willie68/OpenSeaMapLogger/Hardware/OSML_Beschreibung.jpg

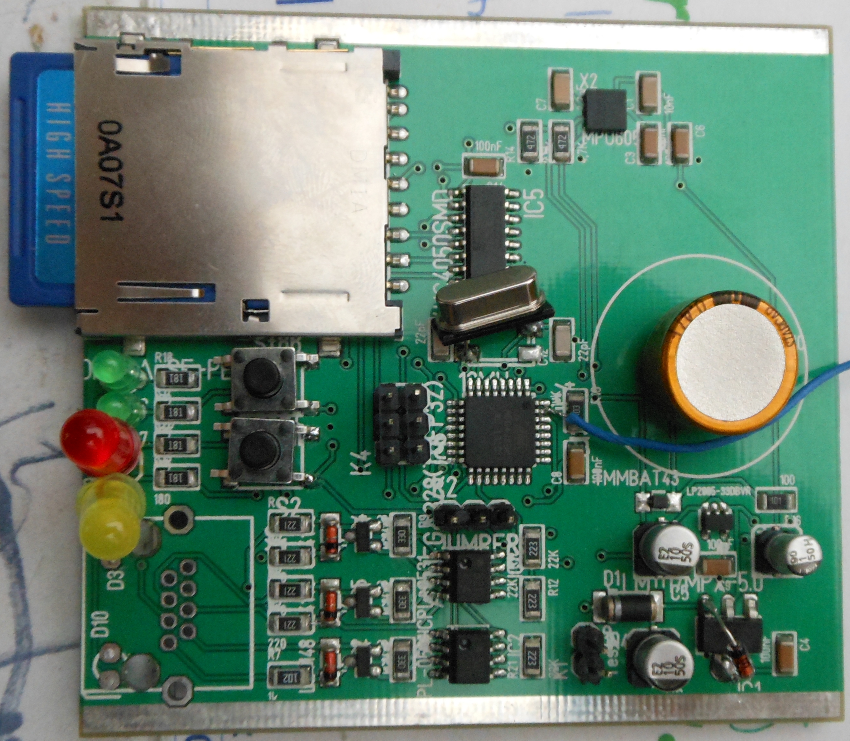
Hardware/OSML_Beschreibung.jpg
