willie68/OpenSeaMapLogger/documentation/DSC_1755.png

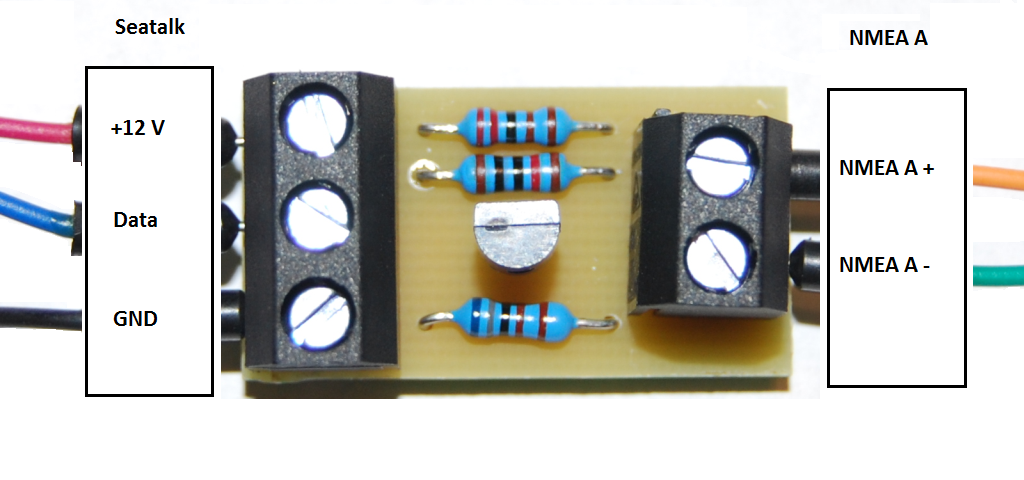
documentation/DSC_1755.png
