willie68/OpenSeaMapLogger/documentation/783px-OpenSeaMap-Logger-NMEA-0183-PS.jpg

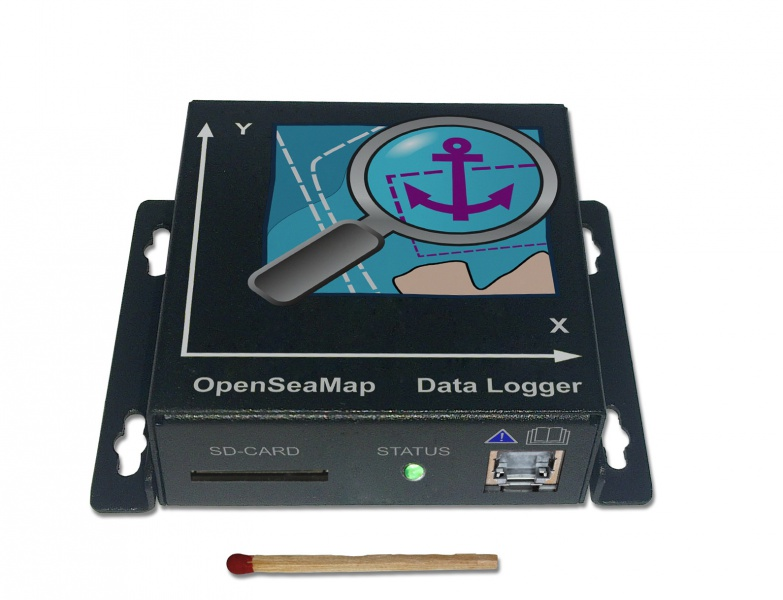
documentation/783px-OpenSeaMap-Logger-NMEA-0183-PS.jpg
