willie68/OpenSeaMapLogger/documentation/800px-Wire_blue_white_stripe.svg.png

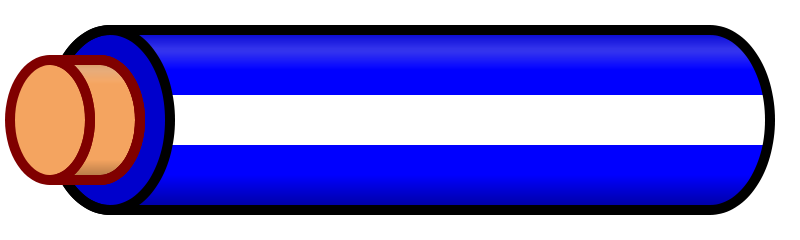
documentation/800px-Wire_blue_white_stripe.svg.png
