willie68/OpenSeaMapLogger/documentation/800px-Wire_white_green_stripe.svg.png

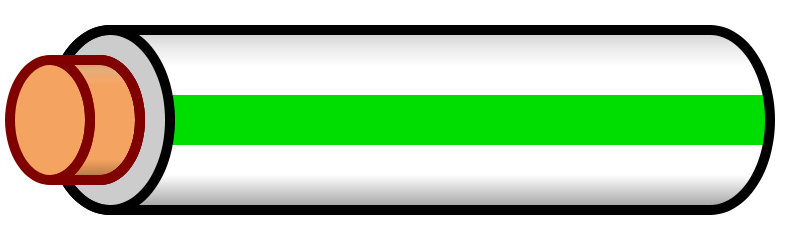
documentation/800px-Wire_white_green_stripe.svg.png
