willie68/OpenSeaMapLogger/documentation/Bilder/Seatalk_001.jpg

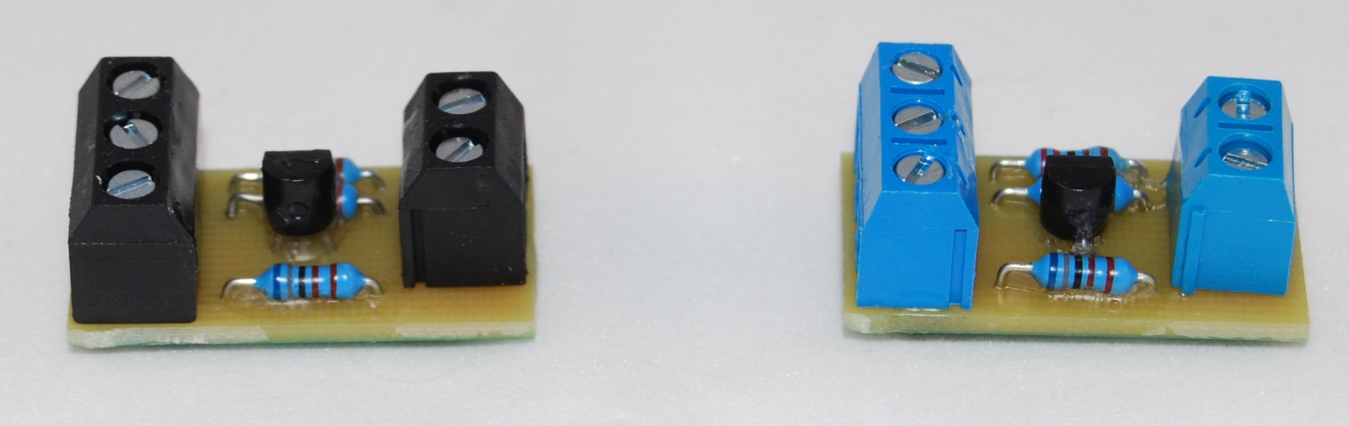
documentation/Bilder/Seatalk_001.jpg
