willie68/OpenSeaMapLogger/documentation/Bilder/Seatalk_003.jpg

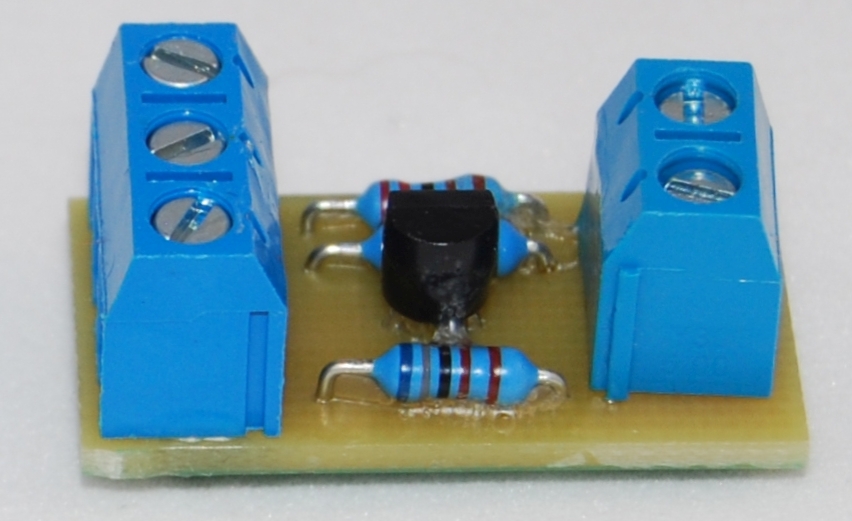
documentation/Bilder/Seatalk_003.jpg
