willie68/OpenSeaMapLogger/documentation/Bilder/Seatalk_004.jpg

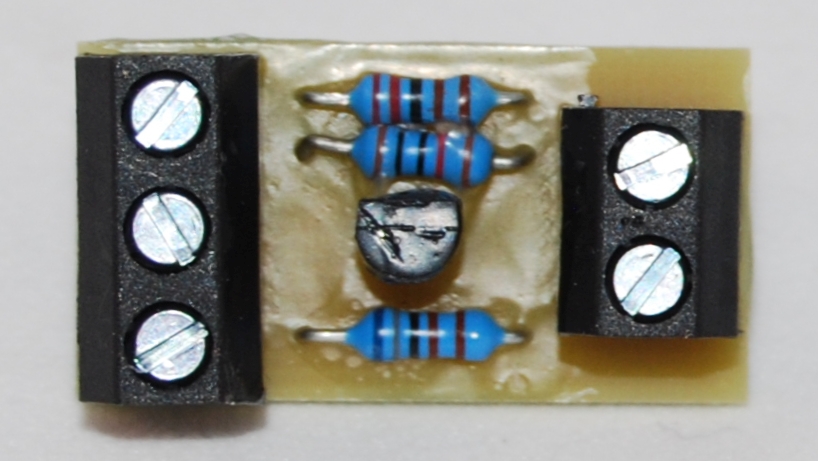
documentation/Bilder/Seatalk_004.jpg
