willie68/OpenSeaMapLogger/documentation/Bilder/Seatalk_005.jpg

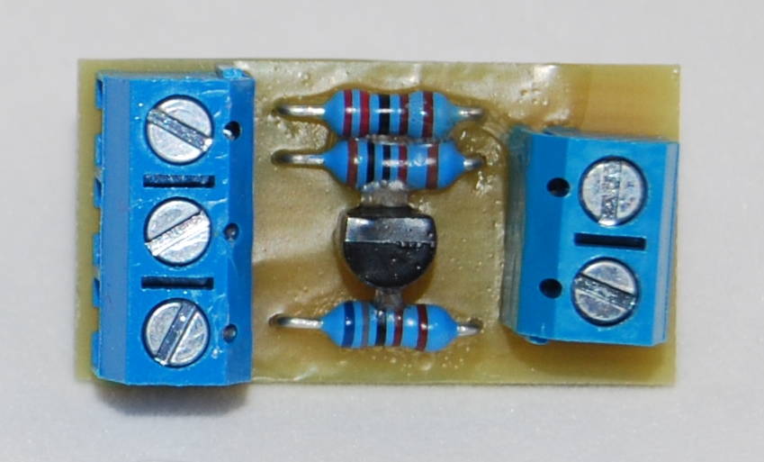
documentation/Bilder/Seatalk_005.jpg
