willie68/OpenSeaMapLogger/documentation/Bilder/Seatalk_006.jpg

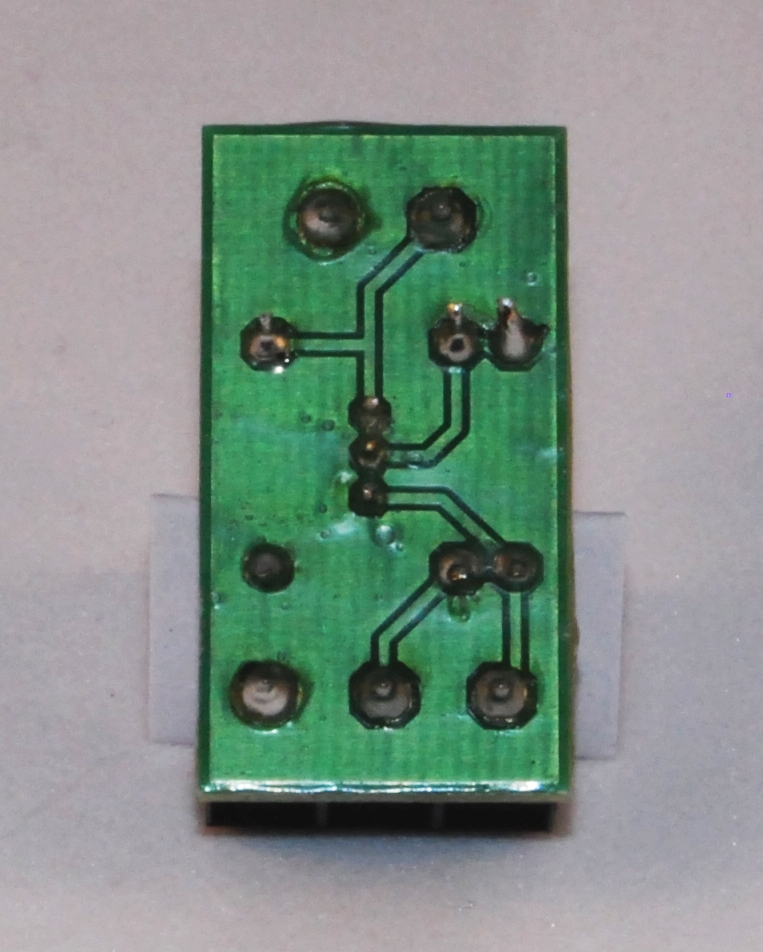
documentation/Bilder/Seatalk_006.jpg
