willie68/OpenSeaMapLogger/documentation/DSC_1755.JPG

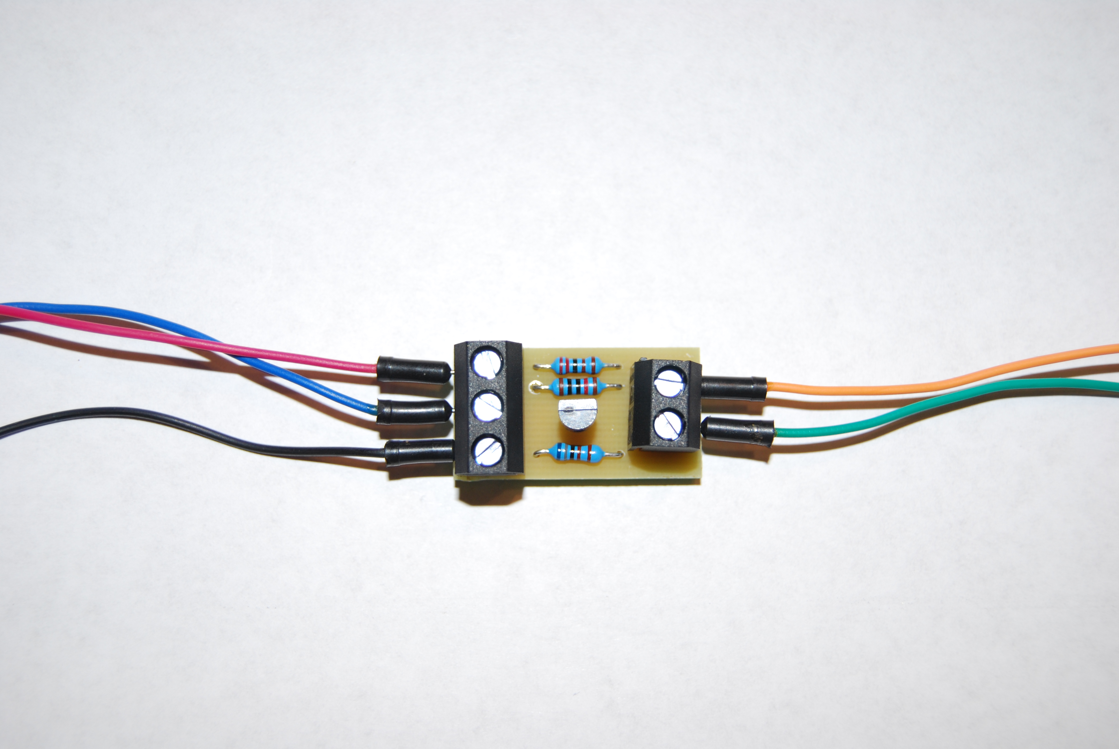
documentation/DSC_1755.JPG
