willie68/OpenSeaMapLogger/documentation/Rj45plug-8p8c.png

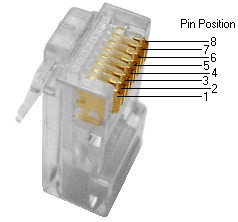
documentation/Rj45plug-8p8c.png
