willie68/OpenSeaMapLogger/documentation/wire_gr_wh.png

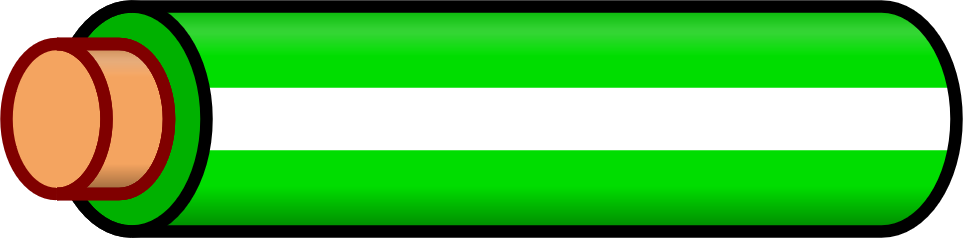
documentation/wire_gr_wh.png
