willie68/OpenSeaMapLogger/documentation/wire_wh_bl.png

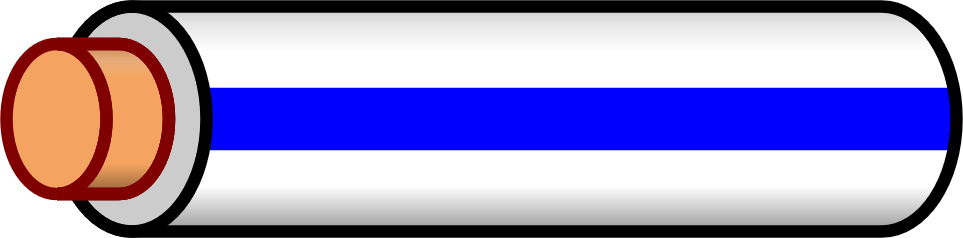
documentation/wire_wh_bl.png
