willie68/OpenSeaMapLogger/WebConfig/screenshot_01.png

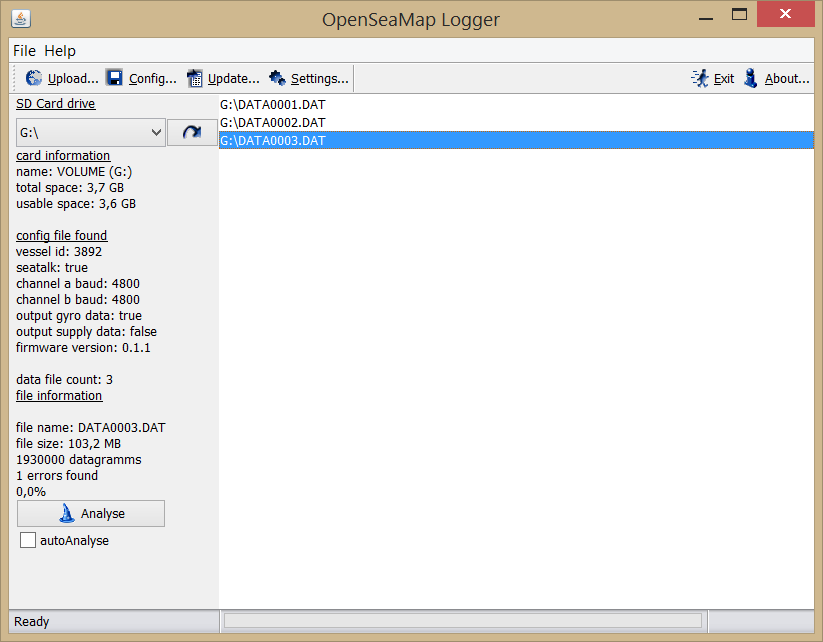
WebConfig/screenshot_01.png
