willie68/OpenSeaMapLogger/documentation/Errata_V1.odt

OpenSeaMap Datenlogger

# Errata

Leider hat sich in das Manual der Fehlerteufel eingeschlichen.

1) In der Originalanleitung sind die Anschlüsse NMEA a und NMEA B vertauscht. Richtig ist:

Pin | -568A Paarnr. | -568B Paarnr. | -568A Farbe | -568B (AT&T 258A) Farbe | Logger Bedeutung

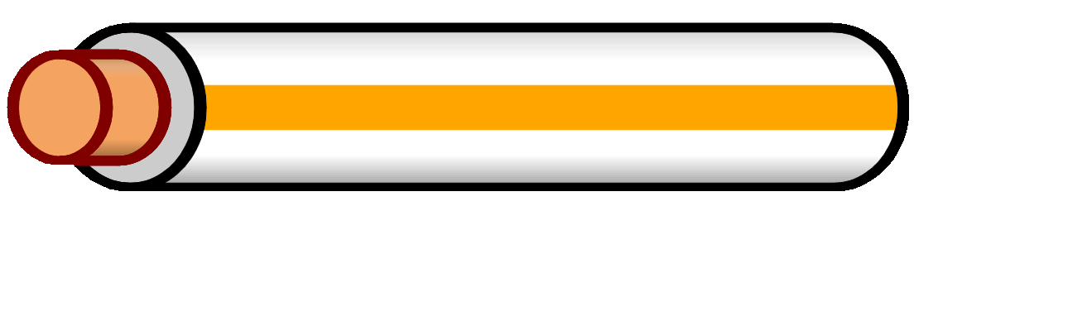
[picture p29: figure]
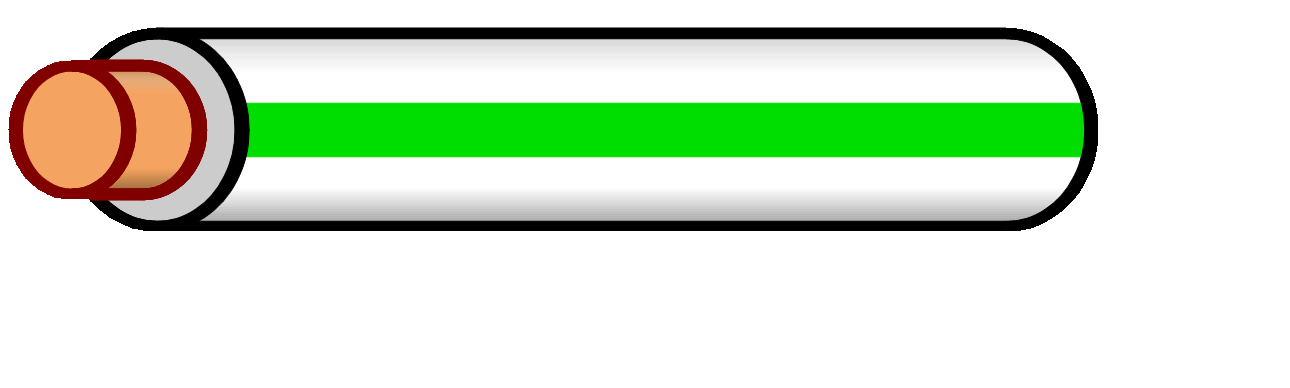
[picture p30: figure]

3 | 2 | 3 | weiß/oranger Strich | weiß/grüner Strich | NMEA B -

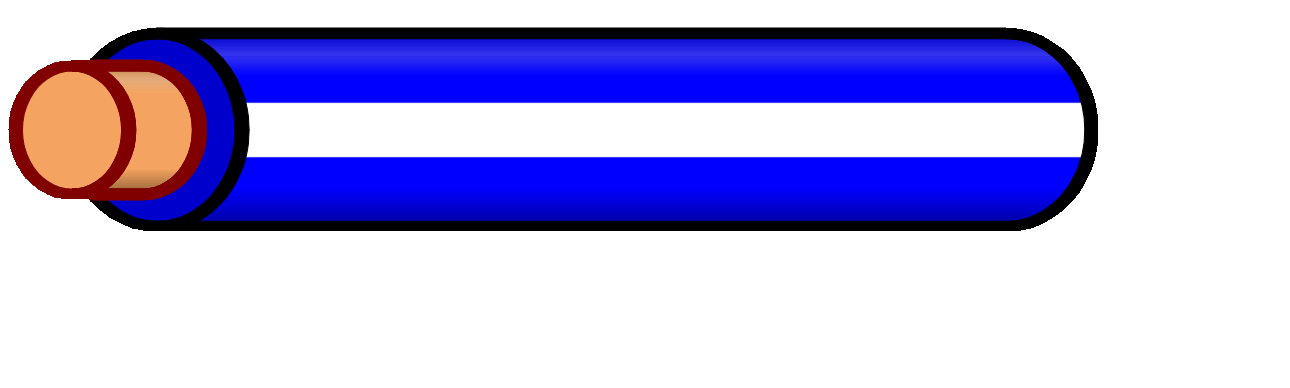
[picture p31: figure]

4 | 1 | 1 | blau/weißer Strich oder blau | blau/weißer Strich oder blau | NMEA A +

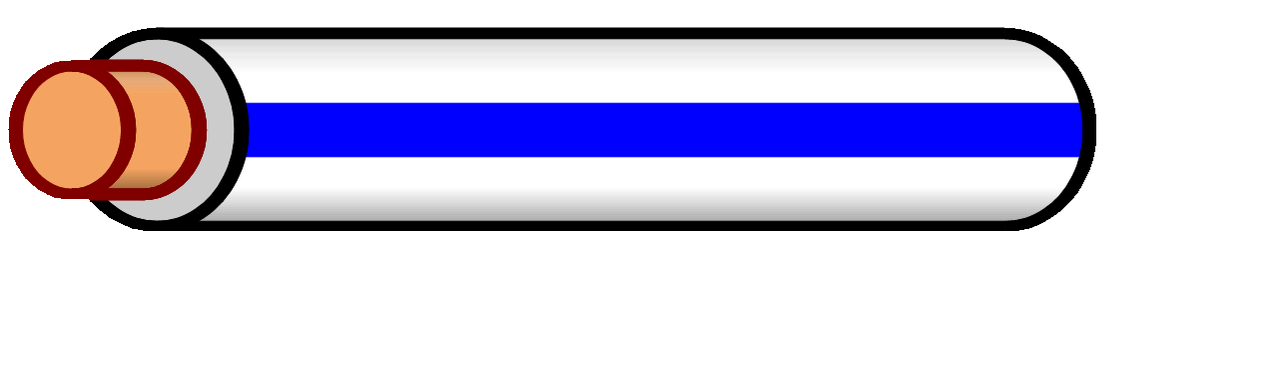
[picture p32: figure]

5 | 1 | 1 | weiß/blauer Strich | weiß/blauer Strich | NMEA A -

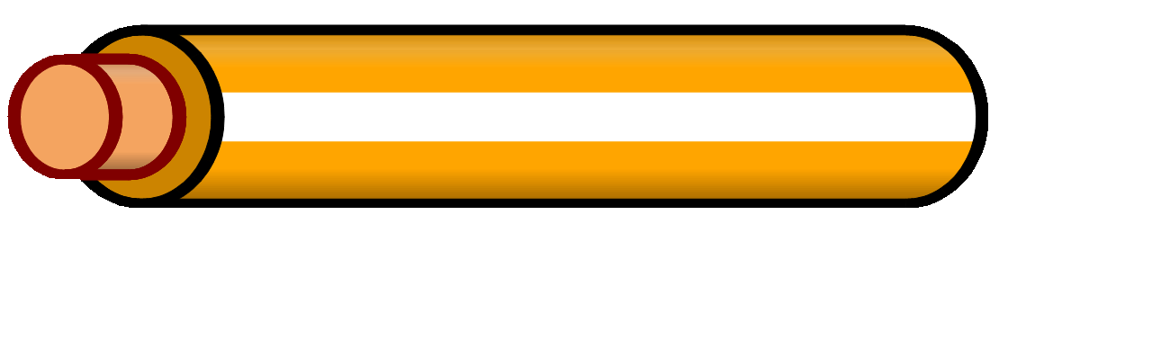
[picture p33: figure]
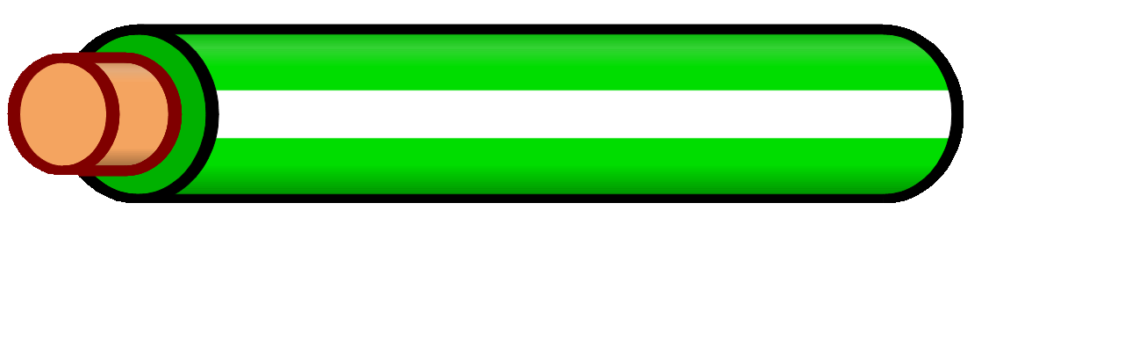
[picture p34: figure]

6 | 2 | 3 | orange/weißer Strich oder orange | grün/weißer Strich oder grün | NMEA B +

### Anschluss Echolot

Signal Echolot | NMEA-A
- | Pin 5
+ | Pin 4

### Anschluss GPS

Signal GPS | NMEA-B
- | Pin 3
+ | Pin 6
