willie68/OpenSeaMapLogger/Hardware/NMEA_Logger_opto_v3.pdf

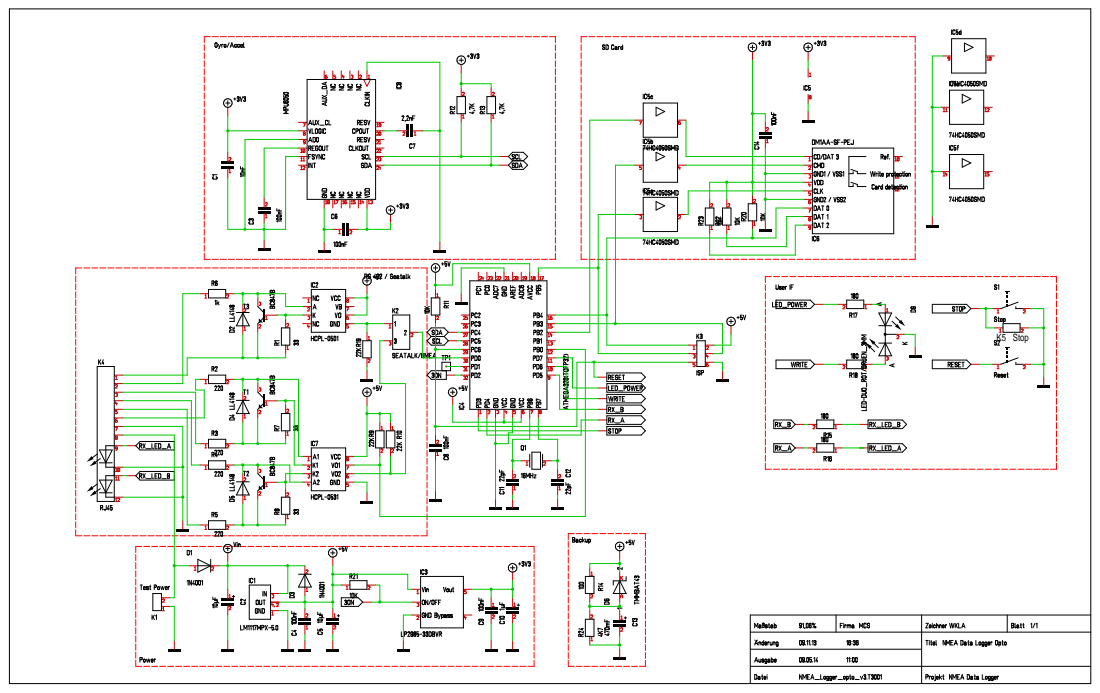
[picture p35: page 1]
K5 Stop
