willie68/OpenSeaMapLogger/Hardware/NMEA_Logger_opto_v2.pdf

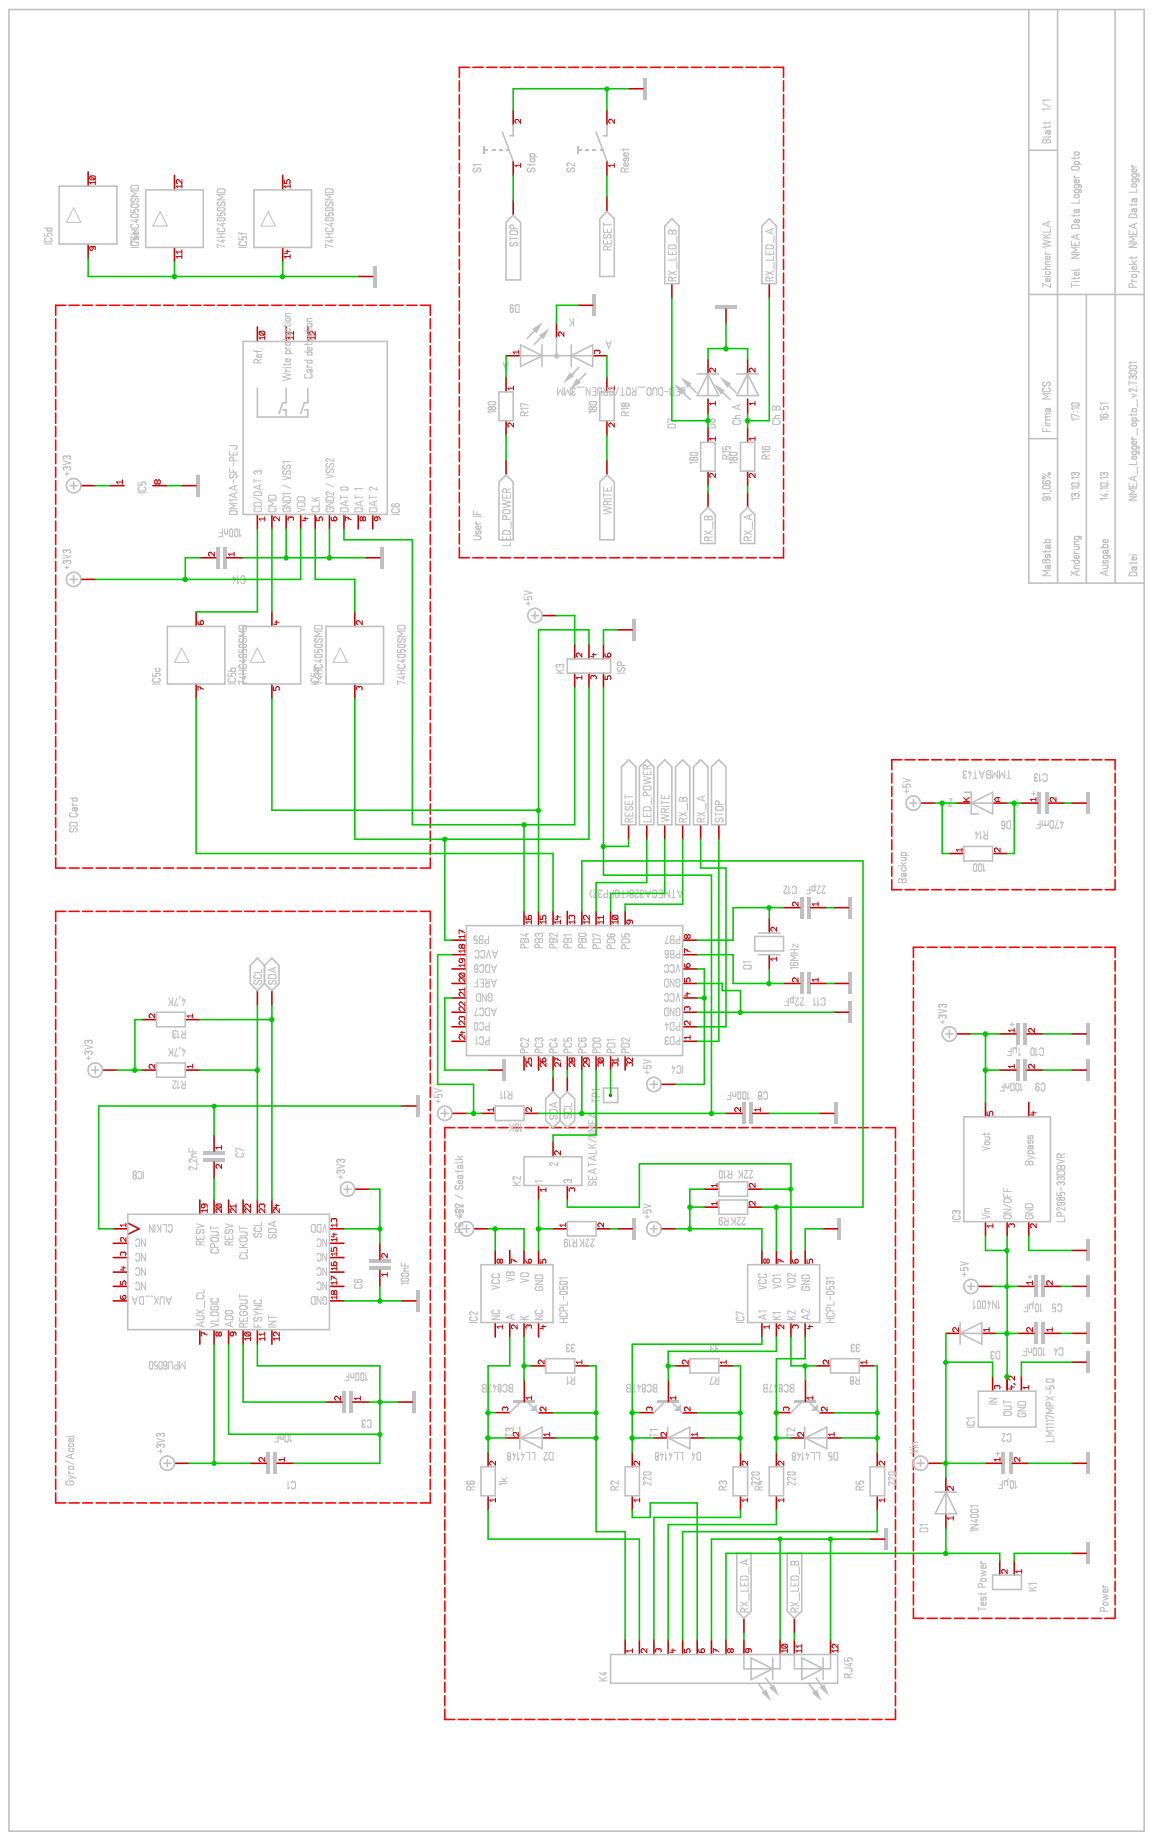
[picture p36: page 1]

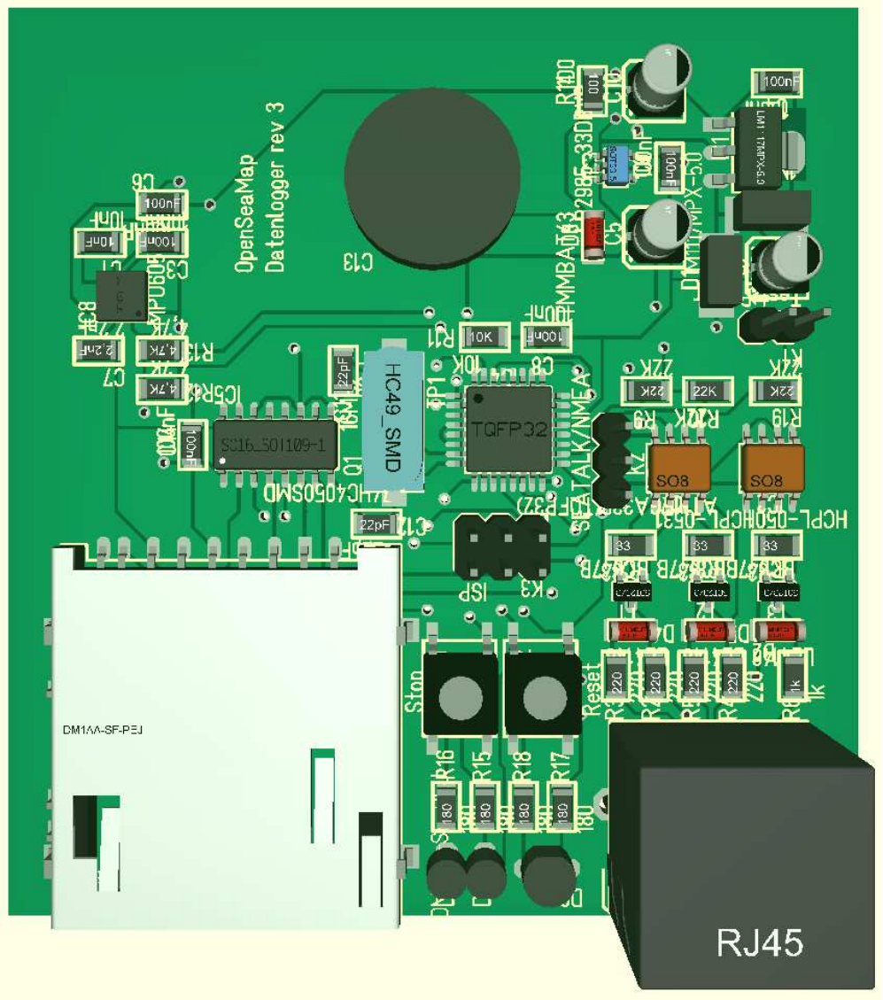
[picture p37: page 2]
