willie68/OpenSeaMapLogger/SketchBook/hardware/OSMLogger/avr/cores/oseam/HardwareSerial.h

/*
  HardwareSerial.h - Hardware serial library for Wiring
  Copyright (c) 2006 Nicholas Zambetti.  All right reserved.

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
  Modified 28 September 2010 by Mark Sproul
  Modified 14 August 2012 by Alarus
  Modified 14 October 2013 by Wilfried Klaas
  - separate buffer sizes for input/output
*/

#ifndef HardwareSerial_h
#define HardwareSerial_h

#include <inttypes.h>

#include "Stream.h"

// Define constants and variables for buffering incoming serial data.  We're
// using a ring buffer (I think), in which head is the index of the location
// to which to write the next incoming character and tail is the index of the
// location from which to read.
#if (RAMEND < 1000)
  #define SERIAL_RX_BUFFER_SIZE 16
  #define SERIAL_TX_BUFFER_SIZE 16
  #define SERIAL_NRX_BUFFER_SIZE 2
  #define SERIAL_NTX_BUFFER_SIZE 2
#else
// changing the buffer to a greater value.
/*  #define SERIAL_RX_BUFFER_SIZE 256
  #define SERIAL_NRX_BUFFER_SIZE 32
*/
  #define SERIAL_RX_BUFFER_SIZE 128
  #define SERIAL_NRX_BUFFER_SIZE 16
  #define SERIAL_TX_BUFFER_SIZE 8
  #define SERIAL_NTX_BUFFER_SIZE 1
#endif

struct ring_buffer;

// Define config for Serial.begin(baud, config);
#define SERIAL_5N1 0x00
#define SERIAL_6N1 0x02
#define SERIAL_7N1 0x04
#define SERIAL_8N1 0x06
#define SERIAL_9N1 0x07   // the lsb is used for the definition of the UCSZn2 in the UCSRnB
#define SERIAL_5N2 0x08
#define SERIAL_6N2 0x0A
#define SERIAL_7N2 0x0C
#define SERIAL_8N2 0x0E
#define SERIAL_9N2 0x0F   // the lsb is used for the definition of the UCSZn2 in the UCSRnB
#define SERIAL_5E1 0x20
#define SERIAL_6E1 0x22
#define SERIAL_7E1 0x24
#define SERIAL_8E1 0x26
#define SERIAL_9E1 0x27   // the lsb is used for the definition of the UCSZn2 in the UCSRnB
#define SERIAL_5E2 0x28
#define SERIAL_6E2 0x2A
#define SERIAL_7E2 0x2C
#define SERIAL_8E2 0x2E
#define SERIAL_9E2 0x2F   // the lsb is used for the definition of the UCSZn2 in the UCSRnB
#define SERIAL_5O1 0x30
#define SERIAL_6O1 0x32
#define SERIAL_7O1 0x34
#define SERIAL_8O1 0x36
#define SERIAL_9O1 0x37   // the lsb is used for the definition of the UCSZn2 in the UCSRnB
#define SERIAL_5O2 0x38
#define SERIAL_6O2 0x3A
#define SERIAL_7O2 0x3C
#define SERIAL_8O2 0x3E
#define SERIAL_9O2 0x3F   // the lsb is used for the definition of the UCSZn2 in the UCSRnB

class HardwareSerial : public Stream
{
  protected:
    ring_buffer *_buffer;
    volatile uint8_t *_ubrrh;
    volatile uint8_t *_ubrrl;
    volatile uint8_t *_ucsra;
    volatile uint8_t *_ucsrb;
    volatile uint8_t *_ucsrc;
    volatile uint8_t *_udr;

    uint8_t _rxen;
    uint8_t _txen;
    uint8_t _rxcie;
    uint8_t _udrie;
    uint8_t _u2x;
    bool transmitting;
	bool _nineBitMode;
	void initBuffer();

    volatile uint8_t _rx_buffer_head;
    volatile uint8_t _rx_buffer_tail;
    volatile uint8_t _tx_buffer_head;
    volatile uint8_t _tx_buffer_tail;
  public:

    HardwareSerial(ring_buffer *buffer,
      volatile uint8_t *ubrrh, volatile uint8_t *ubrrl,
      volatile uint8_t *ucsra, volatile uint8_t *ucsrb,
      volatile uint8_t *ucsrc, volatile uint8_t *udr,
      uint8_t rxen, uint8_t txen, uint8_t rxcie, uint8_t udrie, uint8_t u2x);
    void begin(unsigned long baud) { begin(baud, SERIAL_8N1); }
    void begin(unsigned long, uint8_t);
    void end();
    virtual int available(void);
    virtual int peek(void);
    virtual int read(void);
    virtual void flush(void);
    virtual size_t write(int);
    virtual bool overflow(void);
    inline size_t write(unsigned long n) { return write((int)n); }
    inline size_t write(long n) { return write((int)n); }
    inline size_t write(unsigned int n) { return write((int)n); }
    inline size_t write(uint8_t n) { return write((int)n); }
    using Print::write; // pull in write(str) and write(buf, size) from Print
    operator bool() { return true; }
};



#if defined(UBRRH) || defined(UBRR0H)
  extern HardwareSerial Serial;
  #define HAVE_HWSERIAL0
#elif defined(USBCON)
  #include "USBAPI.h"
//  extern HardwareSerial Serial_;  
#endif
#if defined(UBRR1H)
  extern HardwareSerial Serial1;
  #define HAVE_HWSERIAL1
#endif
#if defined(UBRR2H)
  extern HardwareSerial Serial2;
  #define HAVE_HWSERIAL2
#endif
#if defined(UBRR3H)
  extern HardwareSerial Serial3;
  #define HAVE_HWSERIAL3
#endif

extern void serialEventRun(void) __attribute__((weak));

#endif
