willie68/OpenSeaMapLogger/(commit log)

2013-10-14 Anpassung der Readme
2013-10-16 Anleitung und Bild hinzugefügt.
2013-10-17 - some bug changes in HardwareSerial - adding free memory lib
    [HardwareSerial.cpp, HardwareSerial.h, OpenSeaMap.ino, SimpleLog.ino, osm_makros.h]
2013-10-26 WebModul zum Erstellen der Konfigurationsdatei
2013-10-27 new version with AltSoftSerial. Better performance an lesser errors.
    [HardwareSerial.cpp, HardwareSerial.h, OpenSeaMap.ino, SD_FAT_Tests.ino, SendSeaTalk.ino, TwoSerialTest.ino]
2013-10-28 - new file structure for hardware on arduino 1.5.x
2013-10-29 - EEPROM save - umstrukturierung des Hauptprogrammes
2013-11-01 WKLA 20131101 - Bug in Config DAtei lesen behoben. WKLA 20131029 - Testen auf freien Platz
    [OpenSeaMap.ino, messages.h]
2013-11-01 insert documentation
2013-11-06 Update der Anleitung
2013-11-06 WKLA 20131107 V0.1.5 - Für rev 3 Boards, kann nun die 3V3 Spannungsversorgung geschaltet werden. Dieses wird immer beim fehlerhaften Start der SD Karte gemacht. Für rev 2 und rev 1 Board hat das Verh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
2013-11-10 - new config switches for writing vcc and gyro data.
2013-12-03 update to arduino 1.5.5
2013-12-04 How to build on Linux and whitespace fixes
    [OpenSeaMap.ino, osm_makros.h]
2013-12-19 - new dokumentation. - some changes in handling the 3V3 supply for board revision 3
2014-02-13 neue Version 11. MIt kleineren Änderungen. - neue SDFat Bibliothek. Weniger RAM Gebrauch - Anleitungen - Bootloader mit neuer LED Anschaltung - board.txt angepasst.
2014-03-12 backup version adding some performance and bug fixing.
    [OpenSeaMap.ino, config.h, messages.h]
2014-04-16 // WKLA 20140123 V0.1.12 // - every minutte the logger will flush the file. // - writing version number to eeprom for FAT32 Bootloader // - new stop message with reason why logger creates a new file 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
2014-06-21 some problems with the 9 Bit serial protokoll stack.
    [HardwareSerial.cpp]
2014-07-18 - adding new altsoftserial lib with version number 1.2 - minimize the ram usage of the altsoftserial by setting the transmit buffer to 8 bytes (instead of 68) - Bug #26 - Bug #25 - Bug #19 - Bug #18 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
    [HardwareSerial.cpp, HardwareSerial.h, OpenSeaMap.ino, config.h, messages.h]
2018-04-12 change url for arduino wiki
